YouDad/8bitmodelcomputer/README.md

# 8bitmodelcomputer
## 这是数电课设:8位模型机
## 那么如果发现bug请自行解决,我懒得修
### 请学过组成原理的不要抄,因为这个模型机压根没用组成原理的思想.抄了会被发现的:)
#### 这个模型机的顶层实体是model.bdf,可以看到模型机的组成部件,具体如何设计可以看设计报告.docx
#### 看报告的时候请不要吐槽后面的附录,要吐槽也要吐槽我们老师--,附录真的很傻比,不写会被扣分,是不:)
#### 除了顶层是原理图画的以外,其他都是VHDL代码,也没注释,所以就参考一下就可以了.
###### 此次课设用到EDA是Quartus Prime 17.1,可以到altera官网上下载.
