YouDad/8bitmodelcomputer/(commit log)

2018-07-17 Initial commit
    把写完的课设放到github上.
2018-07-17 报告给你
